homeless-vibecoder/Permanent_magnet_levitation/Attempt_3/force_field.png

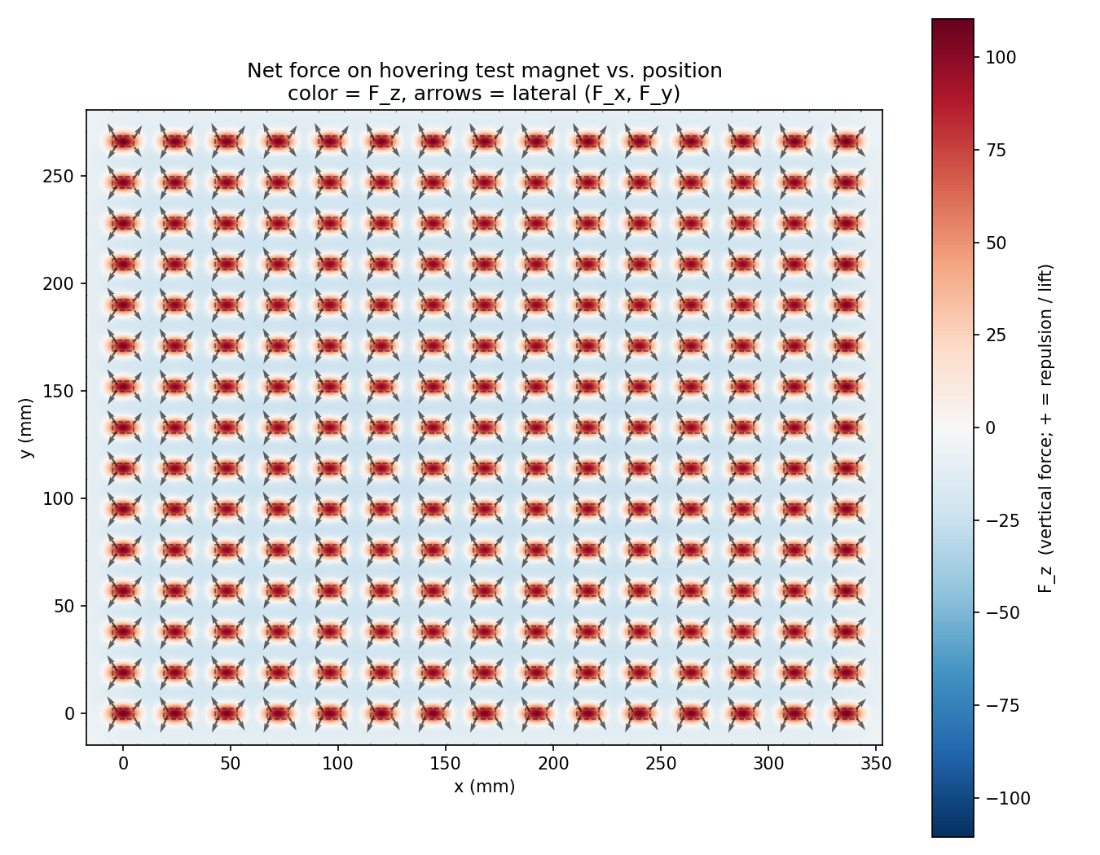
Attempt_3/force_field.png
