homeless-vibecoder/Permanent_magnet_levitation/Attempt_3/force_field_h_2.png

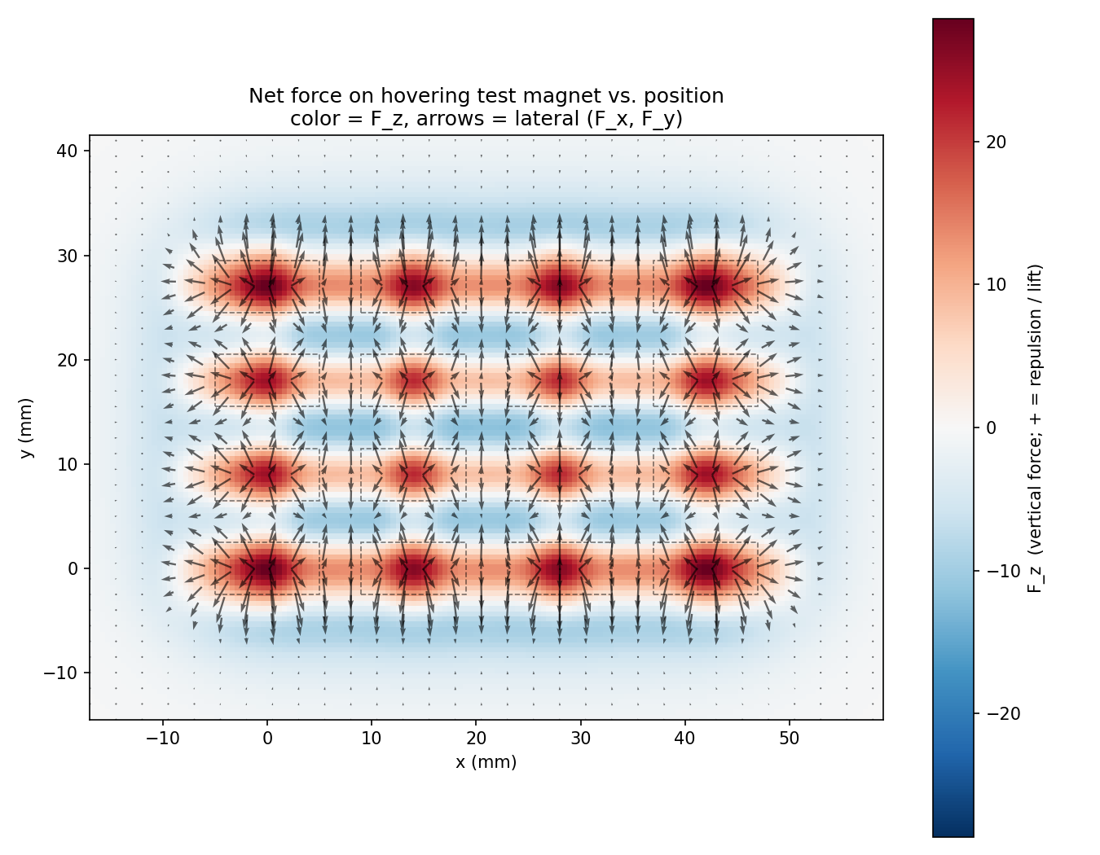
Attempt_3/force_field_h_2.png
