homeless-vibecoder/Permanent_magnet_levitation/graphs/test_charge/images/dipole_Fy_integral.png

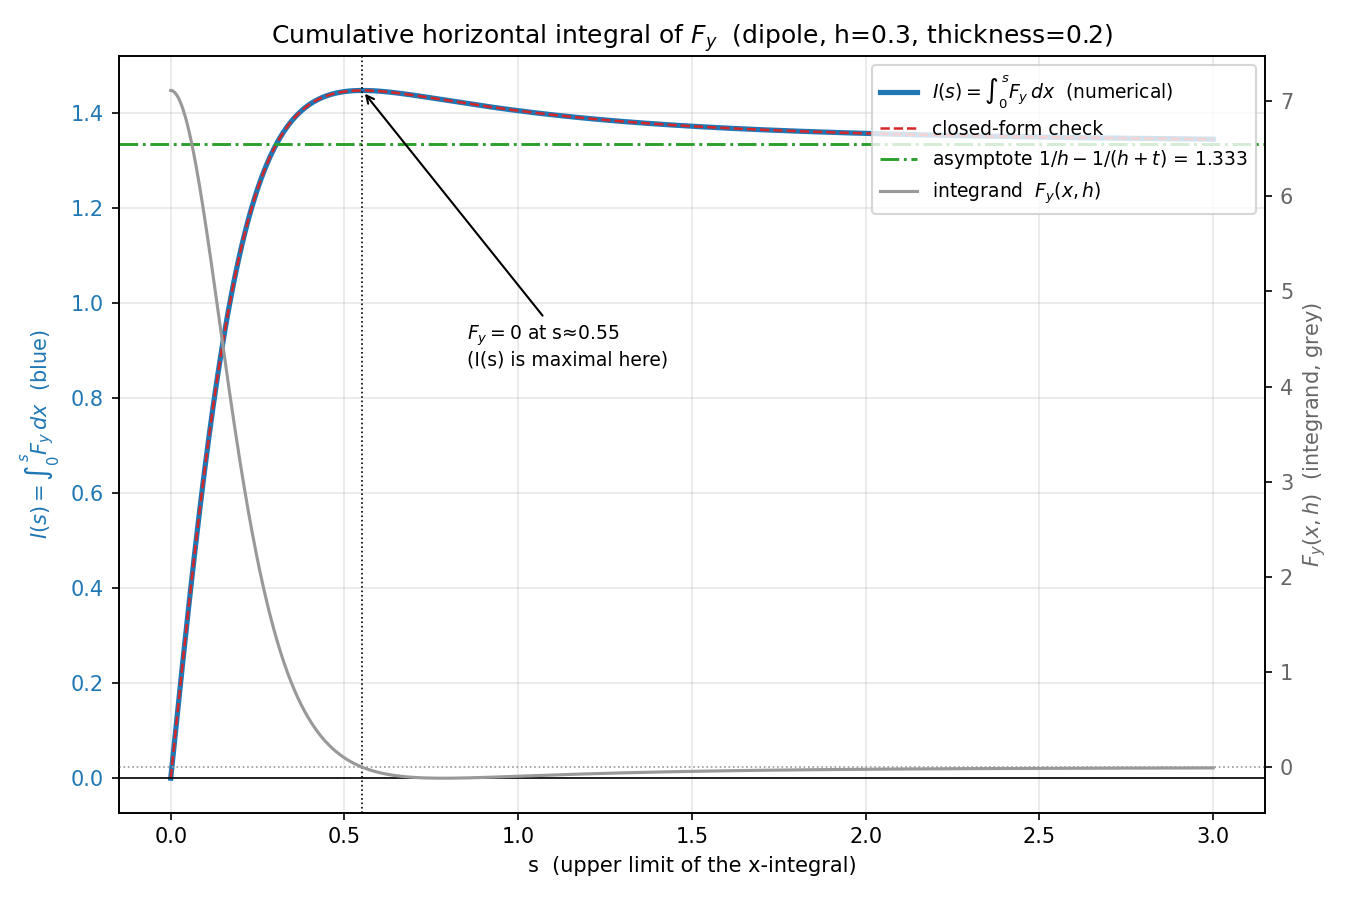
graphs/test_charge/images/dipole_Fy_integral.png
