homeless-vibecoder/Permanent_magnet_levitation/graphs/test_charge/images/dipole_Fy_integration_region.png

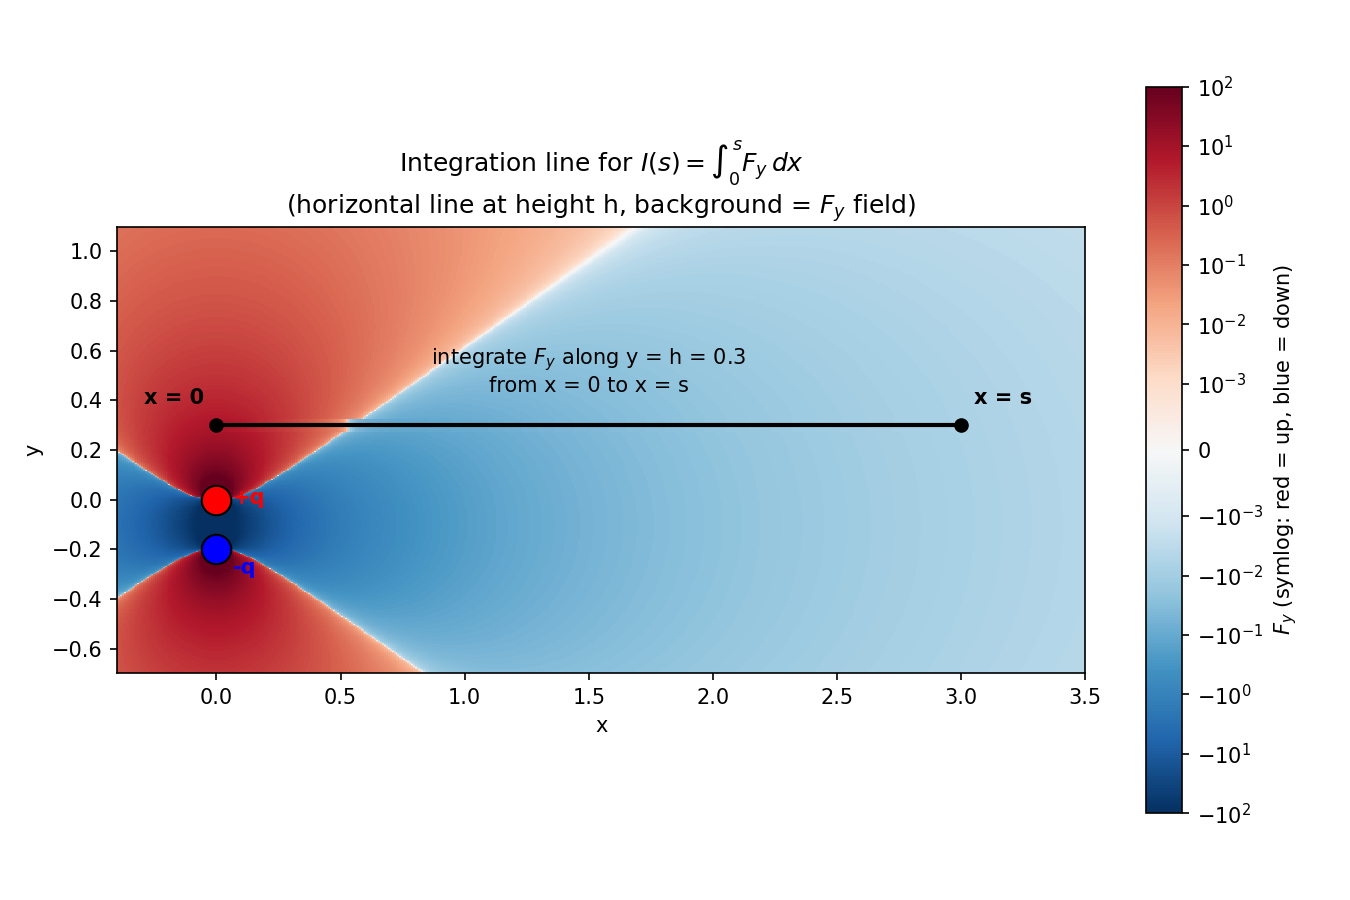
graphs/test_charge/images/dipole_Fy_integration_region.png
