homeless-vibecoder/Permanent_magnet_levitation/graphs/test_charge/images/flat_magnet_force_Fy.png

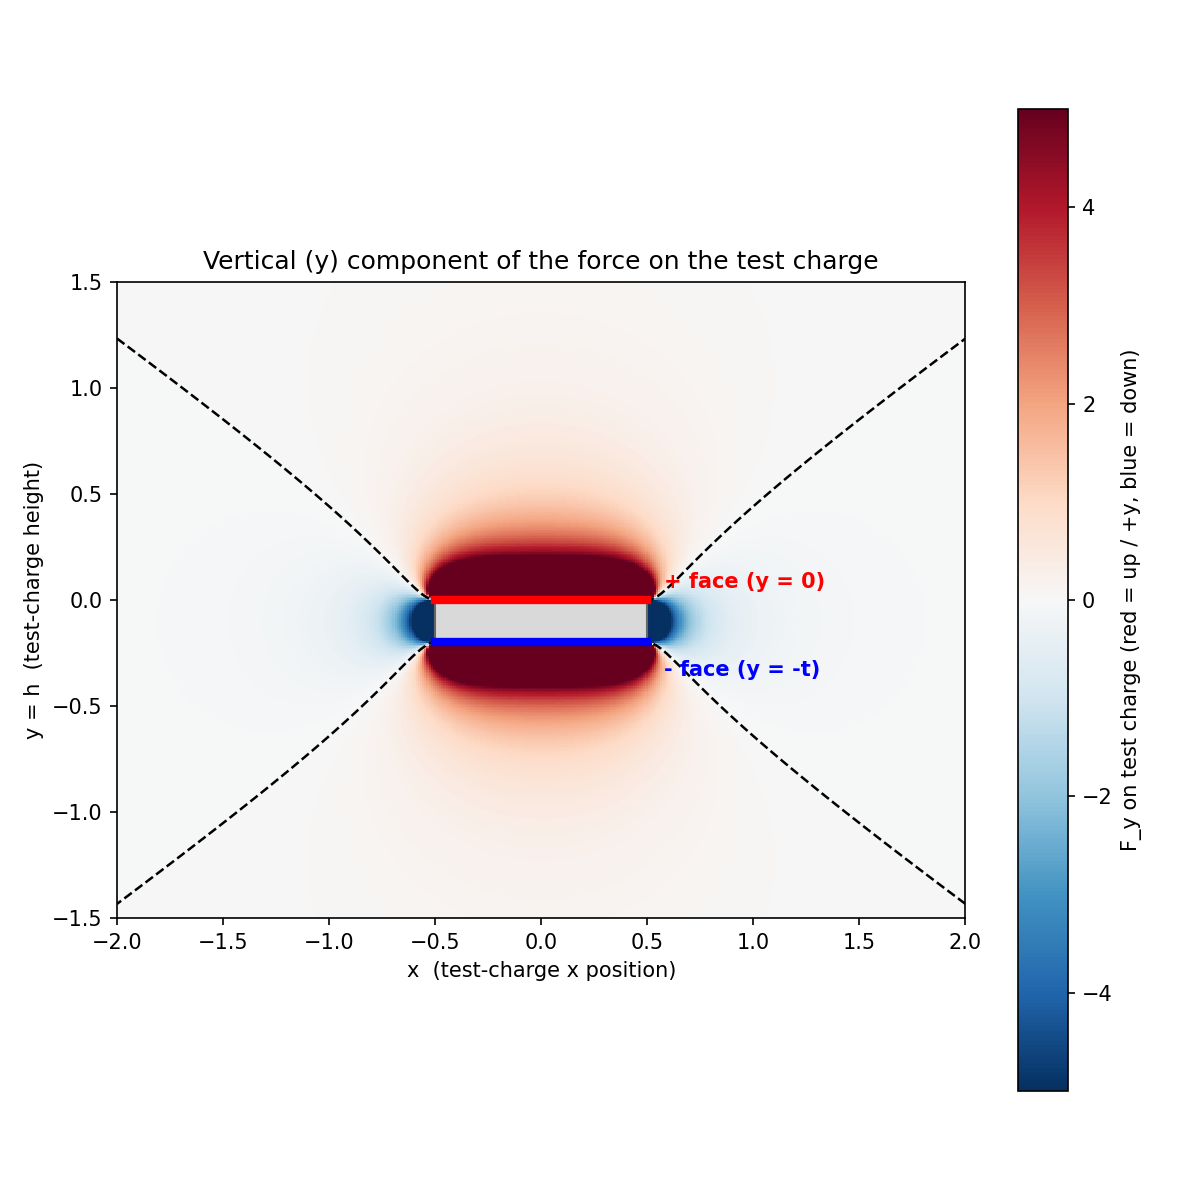
graphs/test_charge/images/flat_magnet_force_Fy.png
