homeless-vibecoder/Permanent_magnet_levitation/graphs/test_charge/images/flat_magnet_force_Fy_symlog.png

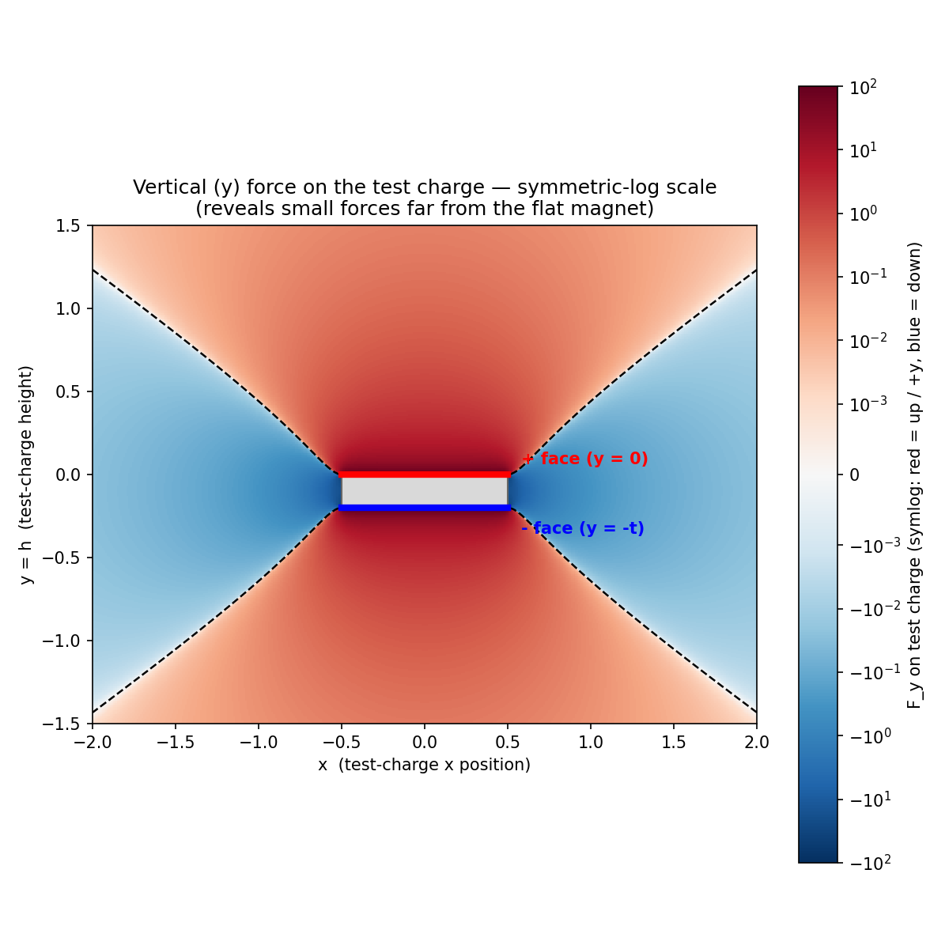
graphs/test_charge/images/flat_magnet_force_Fy_symlog.png
