homeless-vibecoder/Permanent_magnet_levitation/graphs/test_dipole/images/dipole_dipole_force_Fy_symlog.png

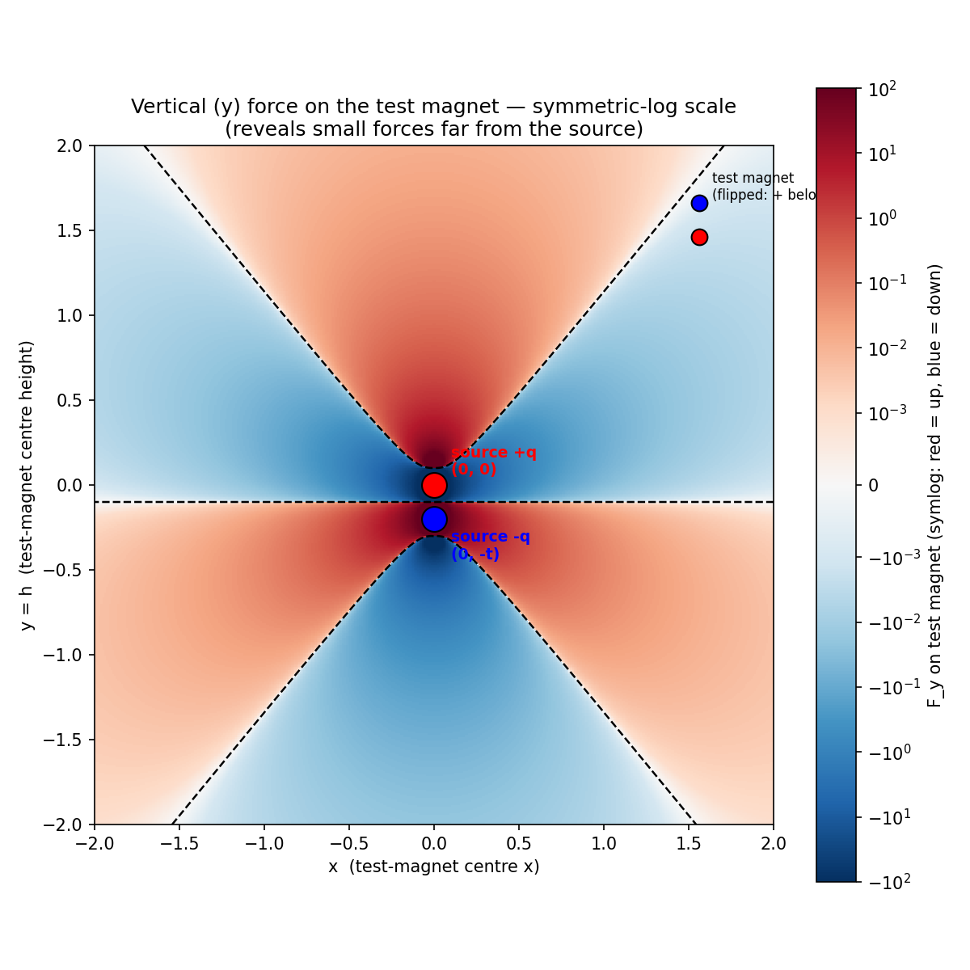
graphs/test_dipole/images/dipole_dipole_force_Fy_symlog.png
