homeless-vibecoder/Permanent_magnet_levitation/graphs/test_dipole/images/dipole_dipole_Fy_integral.png

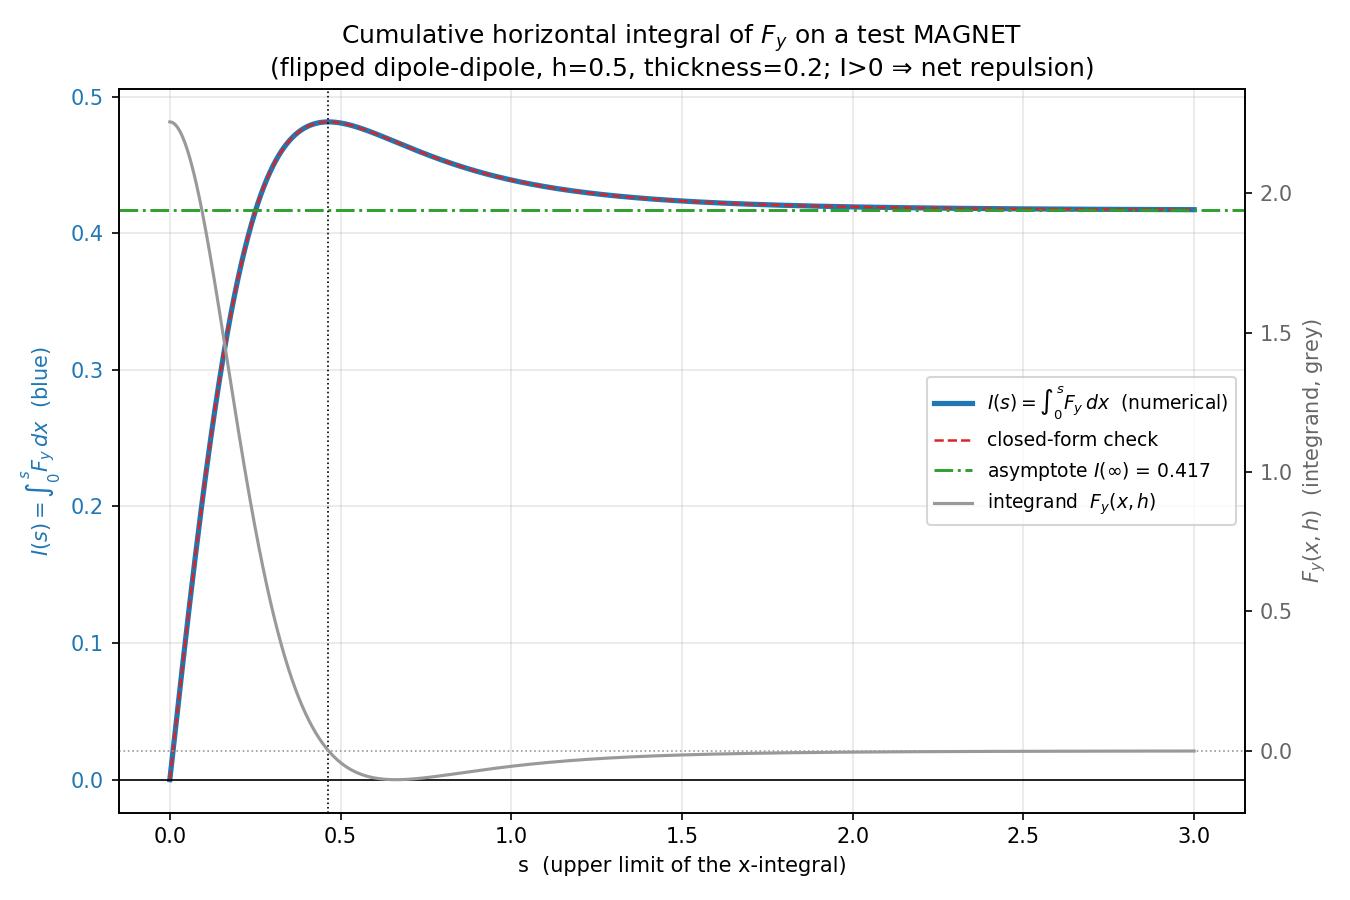
graphs/test_dipole/images/dipole_dipole_Fy_integral.png
