homeless-vibecoder/Permanent_magnet_levitation/(commit log)

2026-06-30 Initial commit: permanent-magnet levitation project bundle
    Writeup (LaTeX + PDF), force-field simulations and layout optimizer
    (Attempt_3), generated graphs, STL/gcode for the magnet holders,
    design canvas, build photos/video, and parts list (BOM).
    Order confirmation image is intentionally gitignored (personal info).
    [parts_list_BOM.csv]
2026-06-30 Add BOM as Excel (.xlsx) for submission
    [parts_list_BOM.xlsx]
2026-06-30 Add project overview on magnetic levitation
    The project explores the concept of magnetic levitation using permanent magnets, detailing design, modeling, and prototyping efforts.
